jaquiroz/Uno/Documentacion/Lista de Componentes.xlsx

LISTA DE COMPONENTES
COMPONENTE | CANTIDAD | ESTADO
Raspberry Pi Zero W | 1
Cable HDMI a Mini HDMI | 1
Raspberry Pi 3B | 1
Arduino Uno | 1
Cable Serial para Arduino | 1
Cable de Alimentacion para Raspberry | 2
Modulo Rele de Estado Solido | 1
Modulo Regulador de Voltaje | 1
Sensor DHT11 | 1
Adptador HDMI a Mini USB | 1
Sensor TEMT6000 | 1
