jaquiroz/Uno/Codigo/Interfaz Grafica/InterfazGrafica/main.py

from mainFrame import MainFrame
from tkinter import Tk

def main():
    root = Tk()
    root.wm_title("Manchester Diferencial")
    app = MainFrame(root)
    app.mainloop()

if __name__ =="__main__":
    main()
    
