jaquiroz/Uno/(commit log)

2020-10-30 Inicio de Proyecto
    [Lista de Componentes.xlsx]
2020-11-06 Creacion de Documentacion
    [Lista de Componentes.xlsx]
2020-11-10 Lectura del sensor de temperatura y humedad
2020-11-11 Agregado conversion de salida a numero binario y salidas digitales para este valor
2020-11-24 Inclusion al codigo la salida de rede de estado solido
2020-11-28 Inclusion de links para la documentacion
2020-11-28 Inclusion del codigo para el receptor
2020-11-28 Revision del codigo para el receptor
2020-12-02 Inclusion de interfaz grafica
